gergely-ferenczy/nixie-clock/README.md

4 digit IN-8-2 Nixie clock with schematic and code implementation for a TM4C1231 microcontroller.
