gergely-ferenczy/nixie-clock/ExtendedBom.xlsx

Sheet: BOM
Qty | Value | Device | Package | Parts | Description | MANUFACTURER | PACKAGE.1 | PARAMETER | PARTNUMBER | VALUE.1 | Column1
1 | 0R05/1% | ERJ8CWFR050V | RESC3216X70N | R2 | SMD Current Sense Resistor, 0R05/1%, 1 W, 1206 [3216], Panasonic | Panasonic | 1206 | 1W | ERJ8CWFR050V | 0R05/1%
2 | 1.5M/1% | MCPWR12FTEA1504 | RESC6331X65N | R5, R6 | SMT Resistor, 1.5M, 1%, 1.5W, 2512 [6432], MULTICOMP PRO | MULTICOMP PRO | 2512 | 1.5W | MCPWR12FTEA1504 | 1.5M/1%
3 | 100k/1% | CRCW0603100KFKEA | RESC1608X50N | R1, R24, R25 | SMT Resistor, 100k/1%, 100mW, 0603, VISHAY | VISHAY | 0603 | 100mW | CRCW0603100KFKEA | 100k/1%
11 | 100n/50V | C0603C104M5RACTU | CAPC1608X80N | C1, C2, C3, C4, C5, C15, C17, C18, C20, C22, C23 | SMT Capacitor, 100n/50V, X7R, 10%, 0603, KEMET | KEMET | 0603 | X7R, 20% | C0603C104M5RACTU | 100n/50V
10 | 10k/1% | CRCW060310K0FKEA | RESC1608X50N | R3, R4, R7, R9, R14, R15, R17, R18, R22, R23 | SMT Resistor, 10k/1%, 100mW, 0603, VISHAY | VISHAY | 0603 | 100mW | CRCW060310K0FKEA | 10k/1%
4 | 10k/1% | CRCW121010K0FKEA | RESC3225X60N | R10, R11, R12, R13 | SMT Resistor, 10k/1%, 500mW, 1210, VISHAY | VISHAY | 1210 | 500mW | CRCW121010K0FKEA | 10k/1%
4 | 10n/50V | C0603C103K5RACTU | CAPC1608X80N | C19, C21, C24, C25 | SMT Capacitor, 10n/50V, X7R, 10%, 0603, KEMET | KEMET | 0603 | X7R, 10% | C0603C103K5RACTU | 10n/50V
1 | 10u/25V | C1206C106K3PACTU | CAPC3216X170N | C16 | SMT Capacitor, 10u/25V, X5R, Â±10%, 1206, KEMET | KEMET | 1206 | X5R | C1206C106K3PACTU | 10u/25V
2 | 12p/50V | C0603C120J5GACTU | CAPC1608X80N | C9, C10 | SMT Capacitor, 12p/50V, C0G/NP0, Â±5%, 0603, KEMET | KEMET | 0603 | C0G/NP0, Â±5% | C0603C120J5GACTU | 12p/50V
1 | 16 MHz | MCSJK-7U-16.00-10-10-80-B-10 | OSCCC320X250X100N | Y1 | SMT Crystal, 16 MHz, SMD, 3.2mm x 2.5mm, 10 ppm, 10 pF, 10 ppm | ABRACON | SMD-4 3.2x2.5 | Â±10ppm, 10pF | MCSJK-7U-16.00-10-10-80-B-10 | 16 MHz
2 | 1u/25V | CL10A105KA8NNNC | CAPC1608X80N | C7, C8 | SMT Capacitor, 1u/25V, X7R, 10%, 0603, SAMSUNG ELECTRO-MECHANICS | SAMSUNG ELECTRO-MECHANICS | 0603 | X7R, 10% | CL10A105KA8NNNC | 1u/25V
2 | 20p/50V | C0603C200J1GACTU | CAPC1608X80N | C11, C12 | SMT Capacitor, 20p/50V, C0G/NP0, Â±5%, 0603, KEMET | KEMET | 0603 | C0G/NP0, Â±5% | C0603C200J1GACTU | 20p/50V
1 | 2k/1% | CRCW06032K00FKEA | RESC1608X50N | R21 | SMT Resistor, 2k/1%, 100mW, 0603, VISHAY | VISHAY | 0603 | 100mW | CRCW06032K00FKEA | 2k/1%
1 | 32.768 kHz | ABS07AIG-32.768KHZ-1-T | OSCCC320X150X90N | Y2 | SMT Crystal, 32.768 kHz, SMD, 3.2mm x 1.5mm, 12.5 pF, 10 ppm | ABRACON | SMD 3.2x1.5 | Â±10 ppm, 12.5 pF | ABS07AIG-32.768KHZ-1-T | 32.768 kHz
2 | 3k3/1% | MCWR06X3301FTL | RESC1608X50N | R19, R20 | SMT Resistor, 3k3/1%, 100mW, 0603, MULTICOMP PRO | MULTICOMP PRO | 0603 | 100mW | MCWR06X3301FTL | 3k3/1%
1 | 3u3/25V | C2012X7R1E335K125 | CAPC2012X145N | C6 | SMT Capacitor, 3u3/25V, X7R, 10%, 0805, TDK | TDK | 0805 | X7R, 10% | C2012X7R1E335K125AB | 3u3/25V
1 | 470u/16V | ECA1CM471 | CAPPRD350W60D800H1150B | C13 | Electrolytic Capacitor, 470 ÂµF, 16 V, Â± 20%, Radial Leaded, Panasonic | Panasonic | Radial 8x11.5 | Alu, 20% | ECA1CM471 | 470u/16V
1 | 4u7/250V | ECA2EHG4R7 | CAPPRD350W60D800H1150B | C14 | Electrolytic Capacitor, 4.7 ÂµF, 250 V, Â± 20%, Radial Leaded, Panasonic | Panasonic | Radial 8x11.5 | Alu, 20% | ECA2EHG4R7 | 4u7/250V
1 | 501568-0607 | MOLEX_501568-0607 | MOLEX_501568-0607 | J3 | PCB Header, 1.00mm Pitch, Pico-Clasp, Single Row, Right-Angle, Surface Mount, Tin Plated, with Inner Positive Lock, 6 Circuits | MOLEX |  |  | 501568-0607 | 501568-0607
1 | 56R/1% | CRCW060356R0FKEA | RESC1608X50N | R8 | SMT Resistor, 56R/1%, 100mW, 0603, VISHAY | VISHAY | 0603 | 100mW | CRCW060333R0FKEA | 56R/1%
1 | 5k/20% | 22AR5K | 22A | R16 | Trimpot, Single Turn, Cermet, Top Adjust, 5 kohm, Surface Mount, 1 Turns | TT ELECTRONICS / BI TECHNOL | 3MM SMD |  |  | 5k/20%
1 | 91V/5% | MMSZ5270BT1G | SOD3716X135N | D1 | Zener Diode, Voltage Regulator, 91 V, 500 mW, 5 %, SOD-123, ON Semiconductor | ON Semiconductor | SOD-123 | 500mW | MMSZ5270BT1G | 91V/5%
1 | BAS321 | BAS321 | SOD2512X110N | D4 | Small Signal Diode, 250 V, 250 mA, 1.25 V, 50 ns, 9 A | NEXPERIA | SOD-323 | 250V, 250mA | BAS321/8F | BAS321
1 | BF820 | BF820 | SOT95P230X110-3N | Q8 | NPN Transistor, Bipolar (BJT), 300 V, 50 mA, 250 mW, SOT-23, NEXPERIA | NEXPERIA | SOT-23 |  | BF820
4 | CLX6E-FKC | CLX6E-FKC | CLX6E-FKC | LED1, LED2, LED3, LED4 | LED, Red, Green, Blue, SMD, Square, R 15mA, G 10mA, B 10mA, CREE | CREE | SMD 3.5x3.4x2.8 mm |  | CLX6E-FKC-CH1M1D1BB7C3D3 | CLX6E-FKC
1 | ES2G-E3/52T | ES2G-E3/52T | DIOM5436X245N | D2 | Fast / Ultrafast Diode, 400 V, 2 A, 900 mV, 35 ns, 50 A, SMB, VISHAY | VISHAY | SMB | 400V/2A | ES2G-E3/52T | ES2G-E3/52T
1 | FQD16N25CTM | FQD16N25CTM | TO230P990X240-3N | Q7 | Power MOSFET, N Channel, 250 V, 16 A, 0.22 ohm, TO-252 (DPAK), Surface Mount | ON Semiconductor | TO-252 |  | FQD16N25CTM
1 | JTAG-ARM-10PIN-PLACEHOLDER | JTAG-ARM-10PIN-PLACEHOLDER | JTAG-ARM-10PIN-PLACEHOLDER | M1 | JTAG 10-pin ARM compatible connector placeholder.
1 | MAX1771ESA+ | MAX1771ESA+ | SOIC127P600X175-8N | IC13 | DC/DC Controller, Boost (Step Up), 3 V to 16.5 V, 1 Output, 300 kHz, SOIC-8 | Maxim Integrated | SOIC-8 |  | MAX1771ESA+
1 | MCP1755T-3302E/DC | MCP1755T-3302E/DC | SOT127P700X180-6N | IC11 | Fixed LDO Voltage Regulator, 3.6V to 16V, 300mV Dropout, 3.3Vout, 300mAout, SOT-223-5, MICROCHIP | MICROCHIP | SOT-223-5 |  | MCP1755T-3302E/DC
1 | MCSDRH125B-101MHF | MCSDRH125B-101MHF | INDM120120X600N | L1 | Power Inductor (SMD), 100 ÂµH, 2.4 A, Shielded, 2.2 A, MCSDRH125B Series, 12.5mm x 12.5mm x 6mm | Multicomp PRO | Square 12.5x6 |  | MCSDRH125B-101MHF
4 | MOUNTING_HOLE_3MM | MOUNTING_HOLE_3MM | MOUNTING_HOLE_3MM | MT1, MT2, MT3, MT4
4 | NIXIE-IN-8-2 | NIXIE-IN-8-2 | NIXIE-IN-8-2 | Q1, Q2, Q3, Q4
2 | PCB Terminal | PCB_TERMINAL_PAD | PCB_TERMINAL_PAD | J1, J2 |  |  |  | 4mmx2mm |  | PCB Terminal
1 | PMEG4030ER | PMEG4010CEJ | SODFL3517X110N | D3 | Schottky Rectifier, 40 V, 3 A, 540 mV, SOD-123W, NEXPERIA | NEXPERIA | SOD-123W | 40V, 3A | PMEG4030ER,115 | PMEG4030ER
1 | S8421-45R | S8421-45R | S8421-45R | PS1 | Battery Holder (Open) Coin, 20.0mm 1 Cell SMD (SMT) Tab | Harwin |  |  | S8421-45R | S8421-45R
4 | SN74HC595DR | SN74HC595DR | SOIC127P600X175-16N | IC5, IC6, IC7, IC8 | 8-Bit Shift Register With 3-State Outputs | Texas Instruments | SOIC-16 |  | SN74HC595DR
4 | SN75468 | SN75468 | SOIC127P600X175-16N | IC1, IC2, IC3, IC4 | 100-V, 7-ch darlington array with TTL or CMOS compatibility | Texas Instruments | SOIC16 |  | SN75468D
2 | TLC5973 | TLC5973 | SOIC127P600X175-8N | IC9, IC10 | LED Driver, 3-Channel, 12-Bit, PWM Constant-Current with Single-Wire Interface, Texas Instruments | Texas Instruments | SOIC-8 |  | TLC5973 | TLC5973
1 | TM4C1231H6PMI | TM4C1231H6PMI | QFP50P1200X1200X160-64N | IC14 |  | Texas Instruments | LQFP-64 |  | TM4C1231H6PMI

Sheet: BOM (2)
Description | Partnumber | Link | QtyPerBoard | Stock | MinOrderAmount | AmountToBeOrdered | Column1
SMD Current Sense Resistor, 0R05/1%, 1 W, 1206 [3216], Panasonic | ERJ8CWFR050V | https://hu.farnell.com/panasonic/erj8cwfr050v/current-sense-res-0r05-1-1-w-1206/dp/2253991 | 1 | 0 | 10 | 10
SMT Resistor, 1.5M, 1%, 1.5W, 2512 [6432], MULTICOMP PRO | MCPWR12FTEA1504 | https://hu.farnell.com/multicomp/mcpwr12ftea1504/res-1m5-1-1-5w-2512-thick-film/dp/1887873 | 2 | 0 | 10 | 20
SMT Resistor, 100k/1%, 100mW, 0603, VISHAY | CRCW0603100KFKEA | https://hu.farnell.com/vishay/crcw0603100kfkea/res-100k-1-0-1w-0603-thick-film/dp/1469649 | 3 | 0 | 10 | 30
SMT Capacitor, 100n/50V, X7R, 10%, 0603, KEMET | C0603C104K5RACTU | https://hu.farnell.com/kemet/c0603c104k5ractu/cap-0-1-f-50v-10-x7r-0603/dp/1288255 | 11 | 0 | 10 | 110 |  | Panel count | 10
SMT Resistor, 10k/1%, 100mW, 0603, VISHAY | CRCW060310K0FKEA | https://hu.farnell.com/vishay/crcw060310k0fkea/res-10k-1-0-1w-0603-thick-film/dp/1469748 | 10 | 0 | 10 | 100
SMT Resistor, 10k/1%, 500mW, 1210, VISHAY | CRCW121010K0FKEA | https://hu.farnell.com/vishay/crcw121010k0fkeahp/res-aec-q200-10k-1-0-75w-1210/dp/3546484 | 4 | 0 | 10 | 40
SMT Capacitor, 10n/50V, X7R, 10%, 0603, KEMET | C0603C103K5RACTU | https://hu.farnell.com/kemet/c0603c103k5ractu/cap-0-01-f-50v-10-x7r-0603/dp/1414609 | 4 | 0 | 10 | 40
SMT Capacitor, 10u/25V, X5R, Â±10%, 1206, KEMET | C1206C106K3PACTU | https://hu.farnell.com/kemet/c1206c106k3pactu/cap-10-f-25v-10-x5r-1206/dp/1288206 | 1 | 0 | 5 | 10
SMT Capacitor, 12p/50V, C0G/NP0, Â±5%, 0603, KEMET | C0603C120J5GACTU | https://hu.farnell.com/kemet/c0603c120j5gactu/cap-12pf-50v-5-c0g-np0-0603/dp/1414612?st=c0603c120j5gactu | 0 | 0 | 10 | 0
SMT Crystal, 16 MHz, SMD, 3.2mm x 2.5mm, 10 ppm, 10 pF, 10 ppm | MCSJK-7U-16.00-10-10-80-B-10 | https://hu.farnell.com/multicomp/mcsjk-7u-16-00-10-10-80-b-10/crystal-16mhz-10pf-3-2mm-x-2-5mm/dp/2853934 | 0 | 0 | 5 | 0
SMT Capacitor, 1u/25V, X7R, 10%, 0603, SAMSUNG ELECTRO-MECHANICS | CL10A105KA8NNNC | https://hu.farnell.com/samsung-electro-mechanics/cl10a105ka8nnnc/cap-1uf-25v-mlcc-0603/dp/3013382 | 2 | 0 | 10 | 20
SMT Capacitor, 20p/50V, C0G/NP0, Â±5%, 0603, KEMET | C0603C200J1GACTU | https://hu.farnell.com/kemet/c0603c200j1gactu/cap-20pf-100v-5-c0g-np0-0603/dp/2821240?st=c0603c200j1gactu | 2 | 0 | 10 | 20
SMT Resistor, 2k/1%, 100mW, 0603, VISHAY | CRCW06032K00FKEA | https://hu.farnell.com/vishay/crcw06032k00fkea/res-2k-1-0-1w-0603-thick-film/dp/1469764 | 1 | 0 | 10 | 10
SMT Crystal, 32.768 kHz, SMD, 3.2mm x 1.5mm, 12.5 pF, 10 ppm | 32.768K-CFPX217 | https://www.tme.eu/hu/details/32.768k-cfpx217/smd-kvarcrezonatorok/iqd-frequency-products/lfxtal009678reel/ | 1 | 0 | 2 | 10 | x
SMT Resistor, 3k3/1%, 100mW, 0603, MULTICOMP PRO | MCWR06X3301FTL | https://hu.farnell.com/multicomp/mcwr06x3301ftl/res-3k3-1-0-1w-0603-thick-film/dp/2447359 | 2 | 0 | 10 | 20
SMT Capacitor, 3u3/25V, X7R, 10%, 0805, TDK | CGA4J1X7R1E335K125AC | https://hu.farnell.com/tdk/cga4j1x7r1e335k125ac/cap-aec-q200-3-3uf-25v-mlcc-0805/dp/3416377 | 1 | 0 | 5 | 10
Electrolytic Capacitor, 470 ÂµF, 16 V, Â± 20%, Radial Leaded, Panasonic | ECA1CM471 | https://hu.farnell.com/panasonic/eca1cm471b/cap-470-f-16v-20/dp/2805533?st=eca1cm471 | 1 | 10 | 1 | 0
Polymer Aluminium Electrolytic Capacitor, 4.7 µF, 250 V, Radial Leaded, A759 Series, 0.496 ohm | A759KS475M2EAAE496 | https://hu.farnell.com/kemet/a759ks475m2eaae496/cap-4-7-f-250v-20/dp/2614117 | 1 | 0 | 1 | 10
PCB Header, 1.00mm Pitch, Pico-Clasp, Single Row, Right-Angle, Surface Mount, Tin Plated, with Inner Positive Lock, 6 Circuits | 501568-0607 | https://hu.farnell.com/molex/501568-0607/connector-header-6pos-1row-1mm/dp/2060673 | 1 | 1 | 1 | 9
SMT Resistor, 56R/1%, 100mW, 0603, VISHAY | CRCW060356R0FKEA | https://hu.farnell.com/vishay/crcw060356r0fkea/res-56r-1-0-1w-0603-thick-film/dp/2141248 | 1 | 0 | 10 | 10
Trimpot, Single Turn, Cermet, Top Adjust, 5 kohm, Surface Mount, 1 Turns | 22AR5K | https://hu.farnell.com/tt-electronics-bi-technologies/22ar5klftr/trimmer-cermet-3mm-5k/dp/1520624?st=22ar5k | 1 | 10 | 5 | 0
Zener Diode, Voltage Regulator, 91 V, 500 mW, 5 %, SOD-123, ON Semiconductor | MMSZ5270BT1G | https://hu.farnell.com/on-semiconductor/mmsz5270bt1g/zener-diode-500mw-91v-sod-123/dp/2463595 | 1 | 3 | 5 | 10
Small Signal Diode, 250 V, 250 mA, 1.25 V, 50 ns, 9 A | BAS321/8F | https://hu.farnell.com/nexperia/bas321-8f/small-signal-diode-250v-0-25a/dp/3439589?st=bas321/8f | 1 | 10 | 5 | 0
NPN Transistor, Bipolar (BJT), 300 V, 50 mA, 250 mW, SOT-23, NEXPERIA | BF820,215 | https://hu.farnell.com/nexperia/bf820-215/transistor-npn-sot-23/dp/1081284 | 1 | 3 | 5 | 10
LED, Red, Green, Blue, SMD, Square, R 15mA, G 10mA, B 10mA, CREE | CLX6E-FKC-CH1M1D1BB7C3D3 | https://hu.farnell.com/cree/clx6e-fkc-ch1m1d1bb7c3d3/led-auto-rgb-500-950-240mcd-plcc6/dp/2839900 | 4 | 4 | 1 | 36
Fast / Ultrafast Diode, 400 V, 2 A, 900 mV, 35 ns, 50 A, SMB, VISHAY | ES2G+ | https://hu.farnell.com/multicomp/es2g/rectifier-single-2a-400v-do-214aa/dp/2674992 | 1 | 5 | 5 | 5
Power MOSFET, N Channel, 250 V, 16 A, 0.22 ohm, TO-252 (DPAK), Surface Mount | FQD16N25CTM | https://hu.farnell.com/on-semiconductor/fqd16n25ctm/mosfet-n-ch-250v-16a-to-252/dp/2101411 | 1 | 10 | 1 | 0
DC/DC Controller, Boost (Step Up), 3 V to 16.5 V, 1 Output, 300 kHz, SOIC-8 | MAX1771ESA+ | https://hu.farnell.com/maxim-integrated-products/max1771esa/controller-step-up-dc-dc-12v-1771/dp/2518766 | 1 | 2 | 1 | 8
Fixed LDO Voltage Regulator, 3.6V to 16V, 300mV Dropout, 3.3Vout, 300mAout, SOT-223-5, MICROCHIP | MCP1755T-3302E/DC | https://hu.farnell.com/microchip/mcp1755t-3302e-dc/ic-ldo-volt-reg-3-3v-0-3a-sot223/dp/2361990 | 1 | 2 | 1 | 8
Power Inductor (SMD), 100 ÂµH, 2.4 A, Shielded, 2.2 A, MCSDRH125B Series, 12.5mm x 12.5mm x 6mm | MCSDRH125B-101MHF | https://hu.farnell.com/multicomp/mcsdrh125b-101mhf/inductor-100-h-20-2pins/dp/1864459 | 1 | 5 | 5 | 5
Schottky Rectifier, 40 V, 3 A, 540 mV, SOD-123W, NEXPERIA | PMEG4030ER,115 | https://hu.farnell.com/nexperia/pmeg4030er-115/diode-schott-rect-40v-3a-sod123w/dp/1829202 | 1 | 5 | 5 | 5
Battery Holder (Open) Coin, 20.0mm 1 Cell SMD (SMT) Tab | S8421-45R | https://hu.farnell.com/harwin/s8421-45r/holder-ez-coin-cr-br2032-cells/dp/2115305 | 1 | 1 | 1 | 9
8-Bit Shift Register With 3-State Outputs | SN74HC595DR | https://hu.farnell.com/texas-instruments/sn74hc595dr/ic-8bit-sipo-shift-register-soic/dp/3006739 | 4 | 0 | 5 | 40
100-V, 7-ch darlington array with TTL or CMOS compatibility | SN75468D | https://hu.farnell.com/texas-instruments/sn75468d/transistor-array-75468-soic16/dp/3009691 | 4 | 0 | 1 | 40
LED Driver, 3-Channel, 12-Bit, PWM Constant-Current with Single-Wire Interface, Texas Instruments | TLC5973 | https://hu.farnell.com/texas-instruments/tlc5973d/led-driver-linear-3mhz-soic-8/dp/3006041 | 2 | 2 | 1 | 18
 | TM4C1231H6PMI | https://hu.farnell.com/texas-instruments/tm4c1231h6pmi/mcu-32bit-cortex-m4f-80mhz-lqfp/dp/3123140 | 1 | 0 | 1 | 10
Phototransistor, 570 nm, 150 °, 2 Pins, Radial Leaded | SFH 3310 | https://hu.farnell.com/osram-opto-semiconductors/sfh-3310/photo-trans-npn-570nm-radial-leaded/dp/2981743 | 1 | 5 | 5 | 5
Contact, Pico-Clasp 501334 Series, Socket, Crimp, 28 AWG, Tin Plated Contacts | 501334-0100 | https://hu.farnell.com/molex/501334-0100/contact-socket-28awg-crimp/dp/1836000 | 6 | 50 | 10 | 10
Connector Housing, Pico-Clasp 501330, Receptacle, 6 Ways, 1 mm, 501334, 501193 Crimp Terminals | 501330-0600 | https://hu.farnell.com/molex/501330-0600/connector-rcpt-6pos-1row-1mm/dp/1835964 | 1 | 1 | 1 | 9
Rotary Encoder, Mechanical, Incremental, 24 PPR, 24 Detents, Vertical, With Momentary Push Switch | PEC11R-4215F-S0024 | https://hu.farnell.com/bourns/pec11r-4215f-s0024/incremental-encoder-2ch-24pulse/dp/2474844 | 1 | 0 | 1 | 10 | x
Socket; DC supply; male; 5.5/2.1mm; with on/off switch; soldering | NEB/J 21 C | https://www.tme.eu/en/details/neb_j21c/dc-power-connectors/lumberg/neb-j-21-c/ | 1 | 5 | 1 | 5 | x
IC & Component Socket, 20 Contacts, SIP Socket, 2.54 mm, D01 Series, Beryllium Copper | D01-9972042 | https://hu.farnell.com/harwin/d01-9972042/socket-sil-20way/dp/1023034 | 44 | 200 | 20 | 240
AC/DC Power Supply, ITE, 1 Output, 12 W, 9 V, 1.28 A | VEL12US090-EU-JA | https://hu.farnell.com/xp-power/vel12us090-eu-ja/adaptor-ac-dc-9v-1-28a/dp/2524419 | 1 | 0 | 1 | 10
