gergely-ferenczy/nixie-clock/Stand-NT-IN-8-2 v1.stl

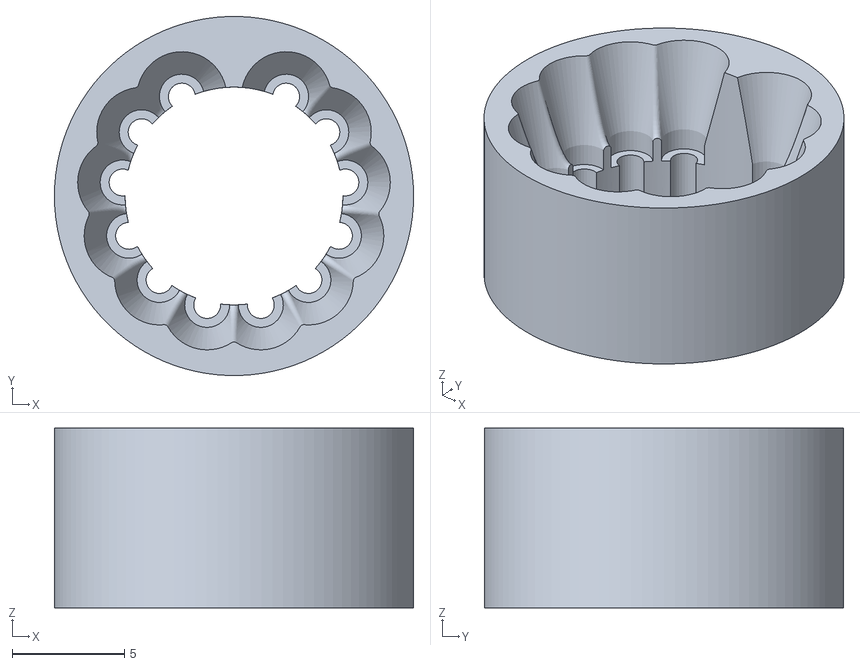
[picture p1: CAD file, 2021-07-18]
Stand-NT-IN-8-2 v1.stl
16.0 x 16.0 x 8.00
