gergely-ferenczy/nixie-clock/NixieClock.dxf

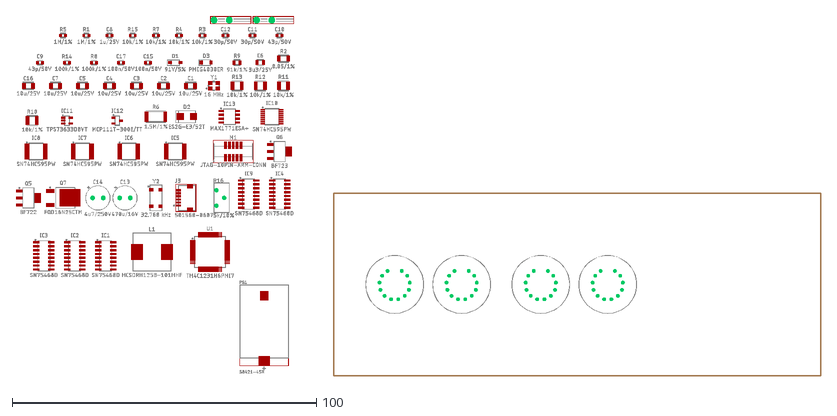
[picture p2: CAD file, 2020-12-04]
NixieClock.dxf
264.3 x 118.1
