gergely-ferenczy/nixie-clock/NixieClock.brd

## EAGLE design NixieClock.brd (2024-01-02)

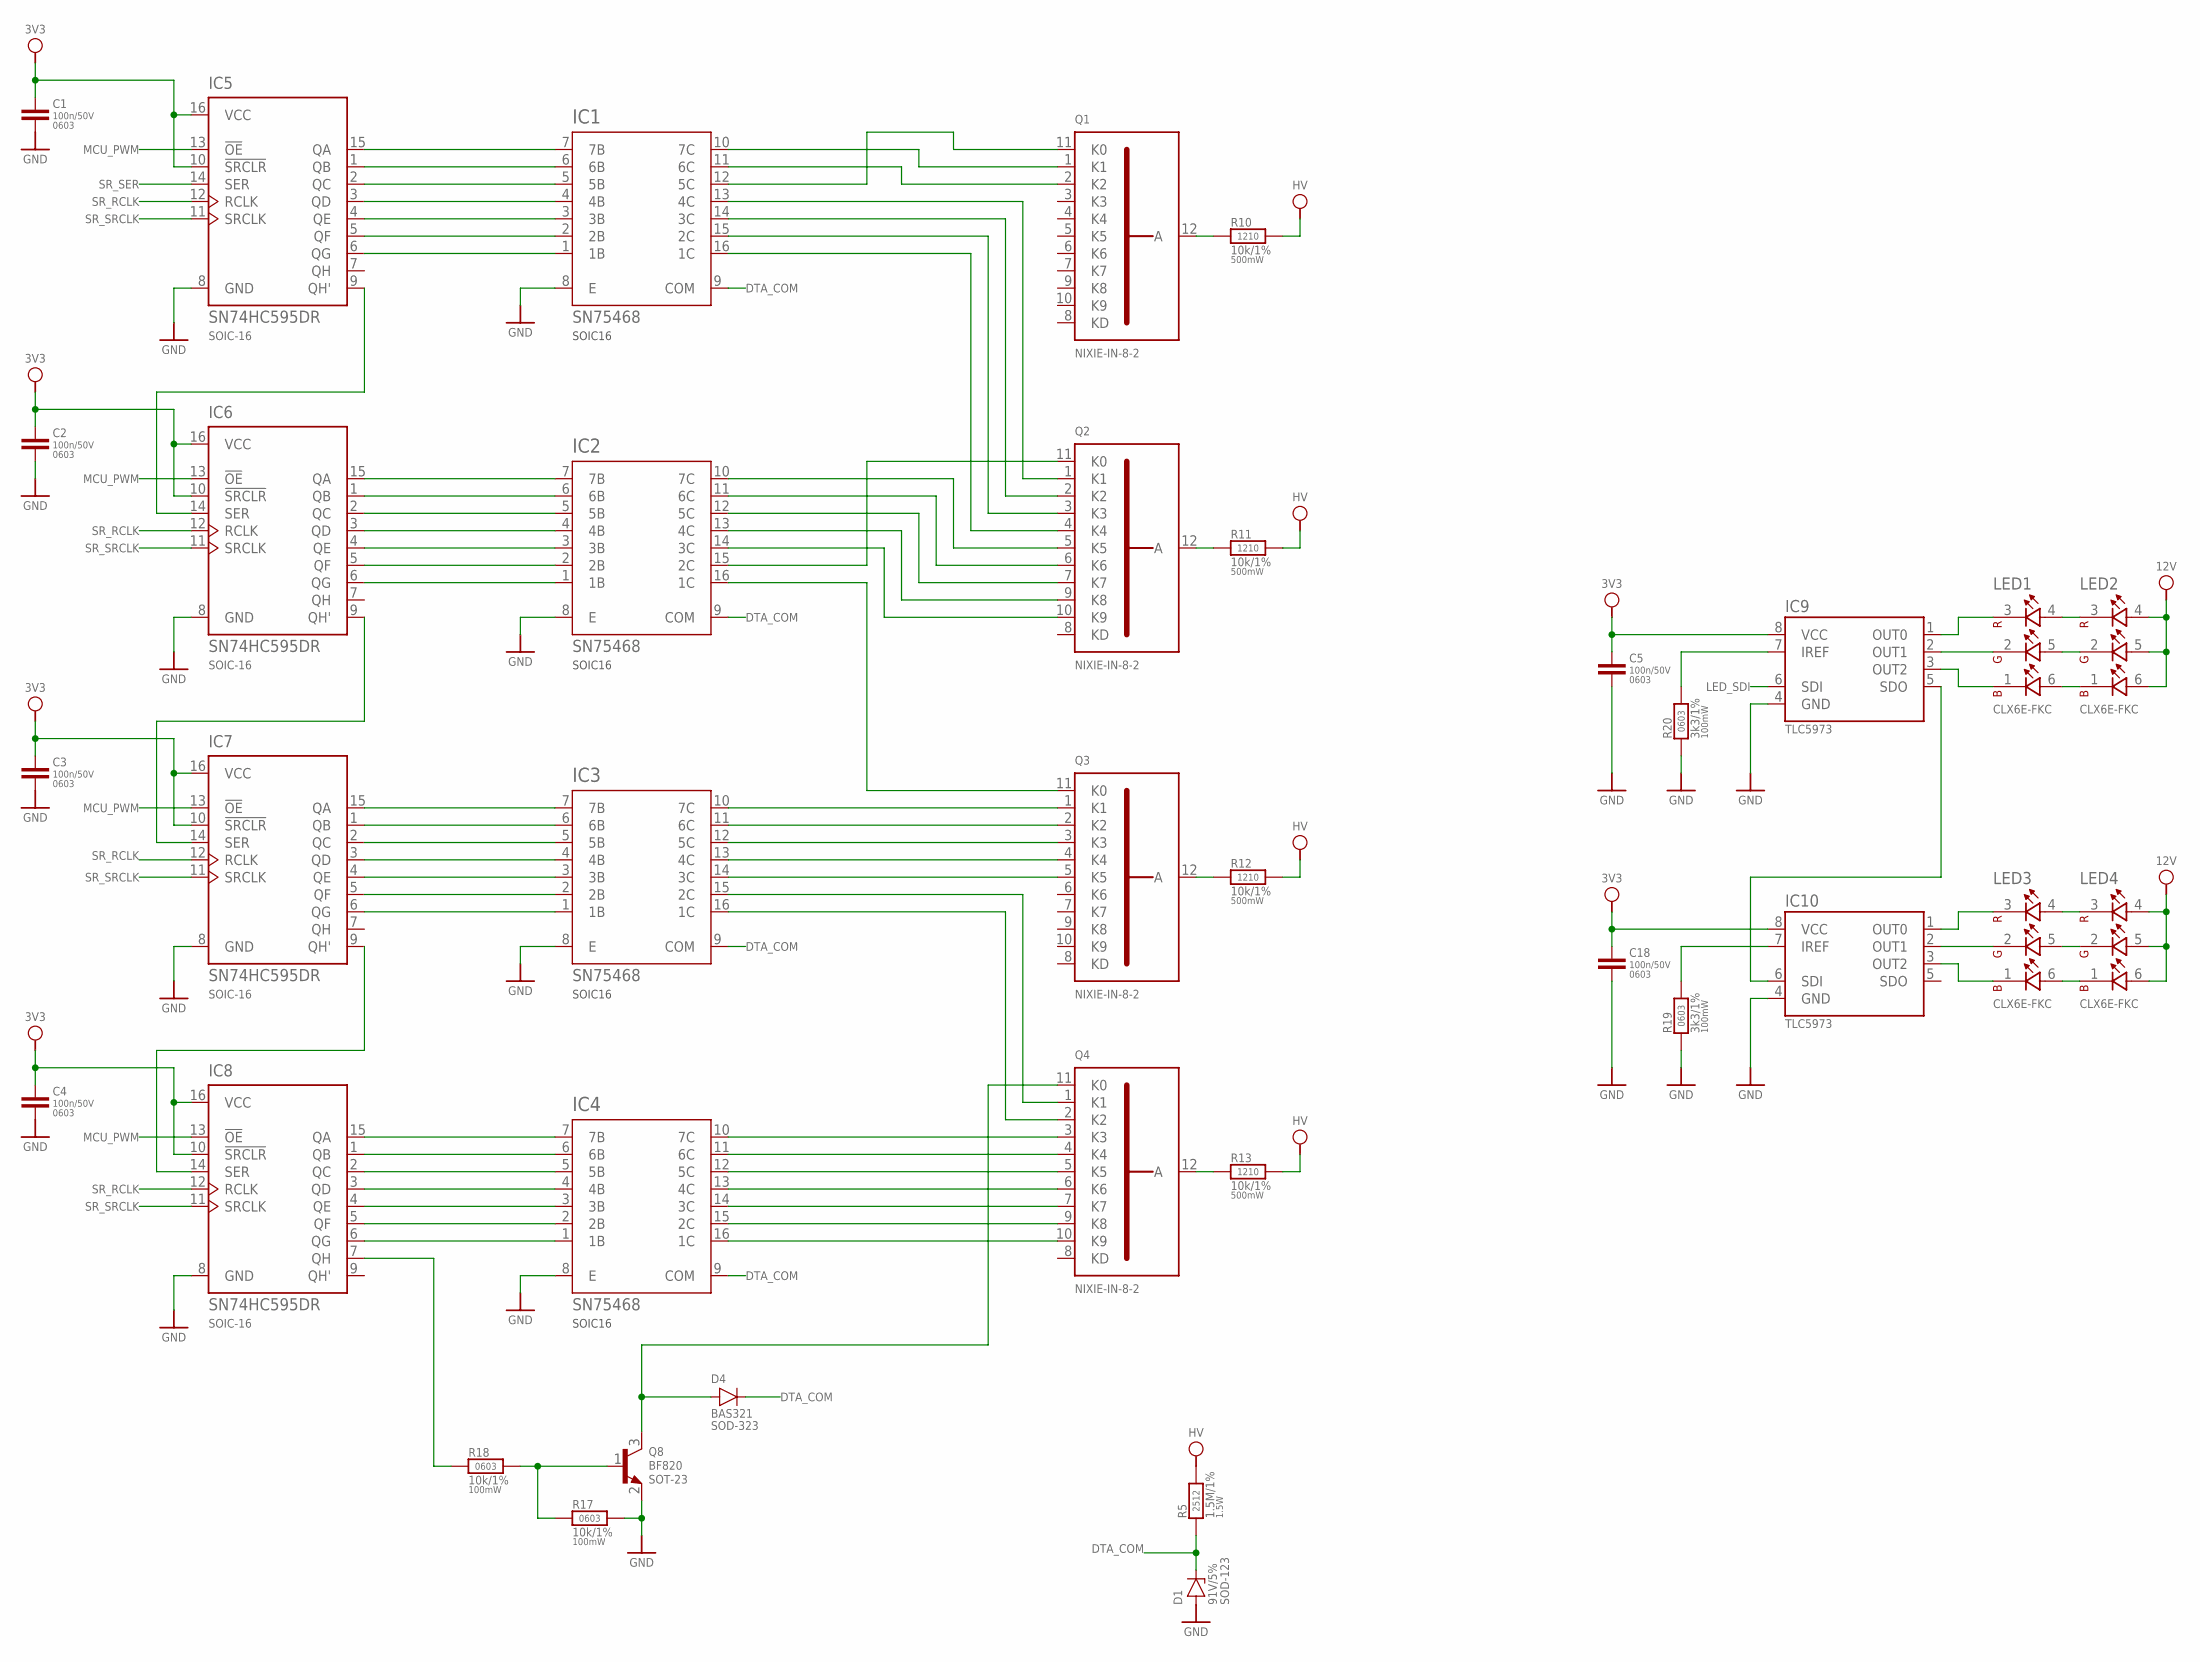
[picture p9: schematic NixieClock.sch, sheet 1, Nixie Control And Driver]

Parts:
C1, C2, C3, C4, C5, C18: 100n/50V; CAPC1608X80N
D1: 91V/5%; SOD3716X135N
D4: BAS321; SOD2512X110N
IC1, IC2, IC3, IC4: SN75468; SOIC127P600X175-16N
IC5, IC6, IC7, IC8: SN74HC595DR; SOIC127P600X175-16N
IC9, IC10: TLC5973; SOIC127P600X175-8N
LED1, LED2, LED3, LED4: CLX6E-FKC
Q1, Q2, Q3, Q4: NIXIE-IN-8-2
Q8: BF820; SOT95P230X110-3N
R5: 1.5M/1%; RESC6331X65N
R10, R11, R12, R13: 10k/1%; RESC3225X60N
R17, R18: 10k/1%; RESC1608X50N
R19, R20: 3k3/1%; RESC1608X50N

Connections:
3V3: C1.1, C2.1, C3.1, C4.1, C5.1, C18.1, IC5.10 (!SRCLR), IC5.16 (VCC), IC6.10 (!SRCLR), IC6.16 (VCC), IC7.10 (!SRCLR), IC7.16 (VCC), IC8.10 (!SRCLR), IC8.16 (VCC), IC9.8 (VCC), IC10.8 (VCC); also elsewhere on the board
12V: LED2.4 (ARED), LED2.5 (AGREEN), LED2.6 (ABLUE), LED4.4 (ARED), LED4.5 (AGREEN), LED4.6 (ABLUE); also elsewhere on the board
DTA_COM: D1.1, D4.1, IC1.9 (COM), IC2.9 (COM), IC3.9 (COM), IC4.9 (COM), R5.1
GND: C1.2, C2.2, C3.2, C4.2, C5.2, C18.2, D1.2, IC1.8 (E), IC2.8 (E), IC3.8 (E), IC4.8 (E), IC5.8 (GND), IC6.8 (GND), IC7.8 (GND), IC8.8 (GND), IC9.4 (GND), IC10.4 (GND), Q8.2 (E), R17.2, R19.1, R20.1; also elsewhere on the board
HV: R5.2, R10.2, R11.2, R12.2, R13.2; also elsewhere on the board
LED_SDI: IC9.6 (SDI); also elsewhere on the board
MCU_PWM: IC5.13 (!OE), IC6.13 (!OE), IC7.13 (!OE), IC8.13 (!OE); also elsewhere on the board
unnamed: IC1.7 (7B), IC5.15 (QA)
unnamed: IC1.6 (6B), IC5.1 (QB)
unnamed: IC1.5 (5B), IC5.2 (QC)
unnamed: IC1.4 (4B), IC5.3 (QD)
unnamed: IC1.3 (3B), IC5.4 (QE)
unnamed: IC1.2 (2B), IC5.5 (QF)
unnamed: IC1.1 (1B), IC5.6 (QG)
unnamed: IC5.9 (QH'), IC6.14 (SER)
unnamed: IC1.10 (7C), Q1.1 (K1)
unnamed: IC1.11 (6C), Q1.2 (K2)
unnamed: IC1.12 (5C), Q1.11 (K0)
unnamed: IC1.13 (4C), Q2.1 (K1)
unnamed: IC1.14 (3C), Q2.2 (K2)
unnamed: IC1.15 (2C), Q2.3 (K3)
unnamed: IC1.16 (1C), Q2.4 (K4)
unnamed: IC6.9 (QH'), IC7.14 (SER)
unnamed: IC2.10 (7C), Q2.5 (K5)
unnamed: IC2.11 (6C), Q2.6 (K6)
unnamed: IC2.12 (5C), Q2.7 (K7)
unnamed: IC2.13 (4C), Q2.9 (K8)
unnamed: IC2.14 (3C), Q2.10 (K9)
unnamed: IC2.15 (2C), Q2.11 (K0)
unnamed: IC2.7 (7B), IC6.15 (QA)
unnamed: IC7.9 (QH'), IC8.14 (SER)
unnamed: IC2.6 (6B), IC6.1 (QB)
unnamed: IC2.5 (5B), IC6.2 (QC)
unnamed: IC2.4 (4B), IC6.3 (QD)
unnamed: IC2.3 (3B), IC6.4 (QE)
unnamed: IC2.2 (2B), IC6.5 (QF)
unnamed: IC2.1 (1B), IC6.6 (QG)
unnamed: IC3.7 (7B), IC7.15 (QA)
unnamed: IC3.6 (6B), IC7.1 (QB)
unnamed: IC3.5 (5B), IC7.2 (QC)
unnamed: IC3.4 (4B), IC7.3 (QD)
unnamed: IC3.3 (3B), IC7.4 (QE)
unnamed: IC3.2 (2B), IC7.5 (QF)
unnamed: IC3.1 (1B), IC7.6 (QG)
unnamed: IC8.7 (QH), R18.1
unnamed: IC9.1 (OUT0), LED1.3 (CRED)
unnamed: IC9.3 (OUT2), LED1.1 (CBLUE)
unnamed: IC9.2 (OUT1), LED1.2 (CGREEN)
unnamed: IC4.11 (6C), Q4.4 (K4)
unnamed: IC10.1 (OUT0), LED3.3 (CRED)
unnamed: IC4.7 (7B), IC8.15 (QA)
unnamed: IC4.6 (6B), IC8.1 (QB)
unnamed: IC4.5 (5B), IC8.2 (QC)
unnamed: IC4.4 (4B), IC8.3 (QD)
unnamed: IC4.3 (3B), IC8.4 (QE)
unnamed: IC4.2 (2B), IC8.5 (QF)
unnamed: IC4.1 (1B), IC8.6 (QG)
unnamed: IC2.16 (1C), Q3.11 (K0)
unnamed: IC3.14 (3C), Q3.5 (K5)
unnamed: IC3.13 (4C), Q3.4 (K4)
unnamed: IC3.12 (5C), Q3.3 (K3)
unnamed: Q1.12 (A), R10.1
unnamed: IC3.11 (6C), Q3.2 (K2)
unnamed: IC3.10 (7C), Q3.1 (K1)
unnamed: IC3.15 (2C), Q4.1 (K1)
unnamed: IC3.16 (1C), Q4.2 (K2)
unnamed: IC4.10 (7C), Q4.3 (K3)
unnamed: IC4.12 (5C), Q4.5 (K5)
unnamed: IC4.13 (4C), Q4.6 (K6)
unnamed: IC4.14 (3C), Q4.7 (K7)
unnamed: Q8.1 (B), R17.1, R18.2
unnamed: IC4.15 (2C), Q4.9 (K8)
unnamed: IC4.16 (1C), Q4.10 (K9)
unnamed: D4.2, Q4.11 (K0), Q8.3 (C)
unnamed: IC10.2 (OUT1), LED3.2 (CGREEN)
unnamed: IC10.3 (OUT2), LED3.1 (CBLUE)
unnamed: Q2.12 (A), R11.1
unnamed: Q3.12 (A), R12.1
unnamed: Q4.12 (A), R13.1
unnamed: LED3.4 (ARED), LED4.3 (CRED)
unnamed: LED3.5 (AGREEN), LED4.2 (CGREEN)
unnamed: LED3.6 (ABLUE), LED4.1 (CBLUE)
unnamed: LED1.4 (ARED), LED2.3 (CRED)
unnamed: LED1.5 (AGREEN), LED2.2 (CGREEN)
unnamed: LED1.6 (ABLUE), LED2.1 (CBLUE)
unnamed: IC9.7 (IREF), R20.2
unnamed: IC10.7 (IREF), R19.2
unnamed: IC9.5 (SDO), IC10.6 (SDI)
SR_RCLK: IC5.12 (RCLK), IC6.12 (RCLK), IC7.12 (RCLK), IC8.12 (RCLK); also elsewhere on the board
SR_SER: IC5.14 (SER); also elsewhere on the board
SR_SRCLK: IC5.11 (SRCLK), IC6.11 (SRCLK), IC7.11 (SRCLK), IC8.11 (SRCLK); also elsewhere on the board

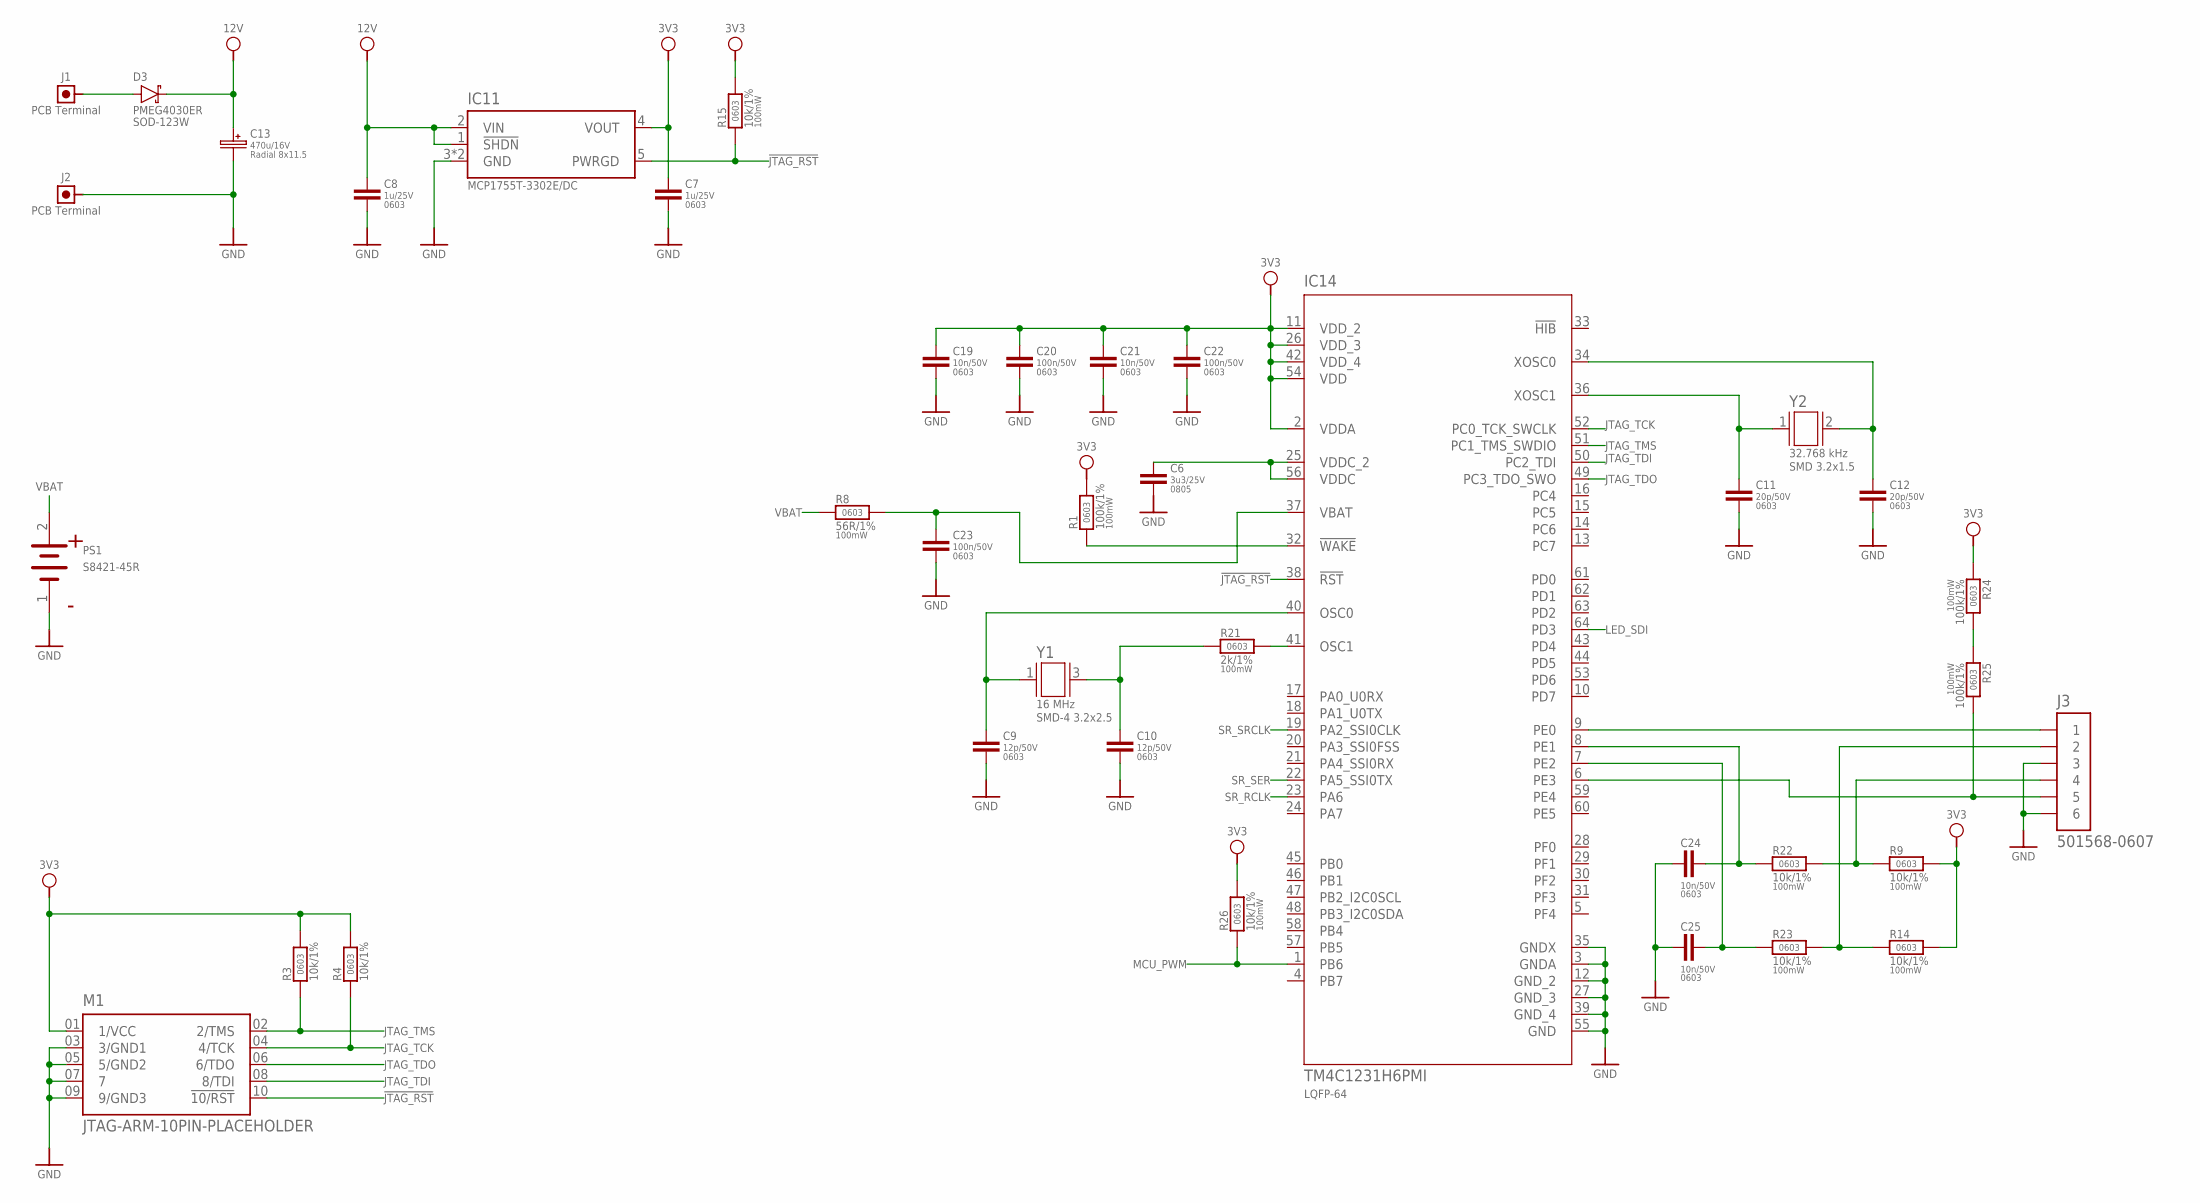
[picture p10: schematic NixieClock.sch, sheet 2, MCU And Connectors]

Parts:
C6: 3u3/25V; CAPC2012X145N
C7, C8: 1u/25V; CAPC1608X80N
C9, C10: 12p/50V; CAPC1608X80N
C11, C12: 20p/50V; CAPC1608X80N
C13: 470u/16V; CAPPRD350W60D800H1150B
C19, C21, C24, C25: 10n/50V; CAPC1608X80N
C20, C22, C23: 100n/50V; CAPC1608X80N
D3: PMEG4030ER; SODFL3517X110N
IC11: MCP1755T-3302E/DC; SOT127P700X180-6N
IC14: TM4C1231H6PMI; QFP50P1200X1200X160-64N
J1, J2: PCB Terminal; PCB_TERMINAL_PAD
J3: 501568-0607; MOLEX_501568-0607
M1: JTAG-ARM-10PIN-PLACEHOLDER
PS1: S8421-45R
R1, R24, R25: 100k/1%; RESC1608X50N
R3, R4, R9, R14, R15, R22, R23, R26: 10k/1%; RESC1608X50N
R8: 56R/1%; RESC1608X50N
R21: 2k/1%; RESC1608X50N
Y1: 16 MHz; OSCCC320X250X100N
Y2: 32.768 kHz; OSCCC320X150X90N

Connections:
3V3: C7.1, C19.1, C20.1, C21.1, C22.1, IC11.4 (VOUT), IC14.2 (VDDA), IC14.11 (VDD_2), IC14.26 (VDD_3), IC14.42 (VDD_4), IC14.54 (VDD), M1.01 (1/VCC), R1.2, R3.2, R4.2, R9.2, R14.2, R15.2, R24.1, R26.2; also elsewhere on the board
12V: C8.1, C13.1, D3.1, IC11.1 (!SHDN), IC11.2 (VIN); also elsewhere on the board
!JTAG_RST: IC11.5 (PWRGD), IC14.38 (!RST), M1.10 (!10/RST), R15.1
!WAKE: IC14.32 (!WAKE), R1.1
GND: C6.2, C7.2, C8.2, C9.2, C10.2, C11.2, C12.2, C13.2, C19.2, C20.2, C21.2, C22.2, C23.2, C24.1, C25.1, IC11.3 (GND), IC11.6 (GND), IC14.3 (GNDA), IC14.12 (GND_2), IC14.27 (GND_3), IC14.35 (GNDX), IC14.39 (GND_4), IC14.55 (GND), J2.1, J3.3, J3.6, M1.03 (3/GND1), M1.05 (5/GND2), M1.07 (7), M1.09 (9/GND3), PS1.1 (CATHODE); also elsewhere on the board
JTAG_TCK: IC14.52 (PC0_TCK_SWCLK), M1.04 (4/TCK), R4.1
JTAG_TDI: IC14.50 (PC2_TDI), M1.08 (8/TDI)
JTAG_TDO: IC14.49 (PC3_TDO_SWO), M1.06 (6/TDO)
JTAG_TMS: IC14.51 (PC1_TMS_SWDIO), M1.02 (2/TMS), R3.1
LED_SDI: IC14.64 (PD3); also elsewhere on the board
MCU_LS: IC14.6 (PE3), J3.5, R25.2
MCU_PWM: IC14.1 (PB6), R26.1; also elsewhere on the board
MCU_QEA: C24.2, IC14.8 (PE1), R22.1
MCU_QEB: C25.2, IC14.7 (PE2), R23.1
MCU_SW: IC14.9 (PE0), J3.1
MCU_VBAT: C23.1, IC14.37 (VBAT), R8.2
MCU_VDDC: C6.1, IC14.25 (VDDC_2), IC14.56 (VDDC)
unnamed: R24.2, R25.1
unnamed: IC14.41 (OSC1), R21.2
OSC0: C9.1, IC14.40 (OSC0), Y1.1
OSC1: C10.1, R21.1, Y1.3 (2)
QEA_RAW: J3.4, R9.1, R22.2
QEB_RAW: J3.2, R14.1, R23.2
SR_RCLK: IC14.23 (PA6); also elsewhere on the board
SR_SER: IC14.22 (PA5_SSI0TX); also elsewhere on the board
SR_SRCLK: IC14.19 (PA2_SSI0CLK); also elsewhere on the board
VBAT: PS1.2 (ANODE), R8.1
VSUPP: D3.2, J1.1
XOSC0: C12.1, IC14.34 (XOSC0), Y2.2
XOSC1: C11.1, IC14.36 (XOSC1), Y2.1

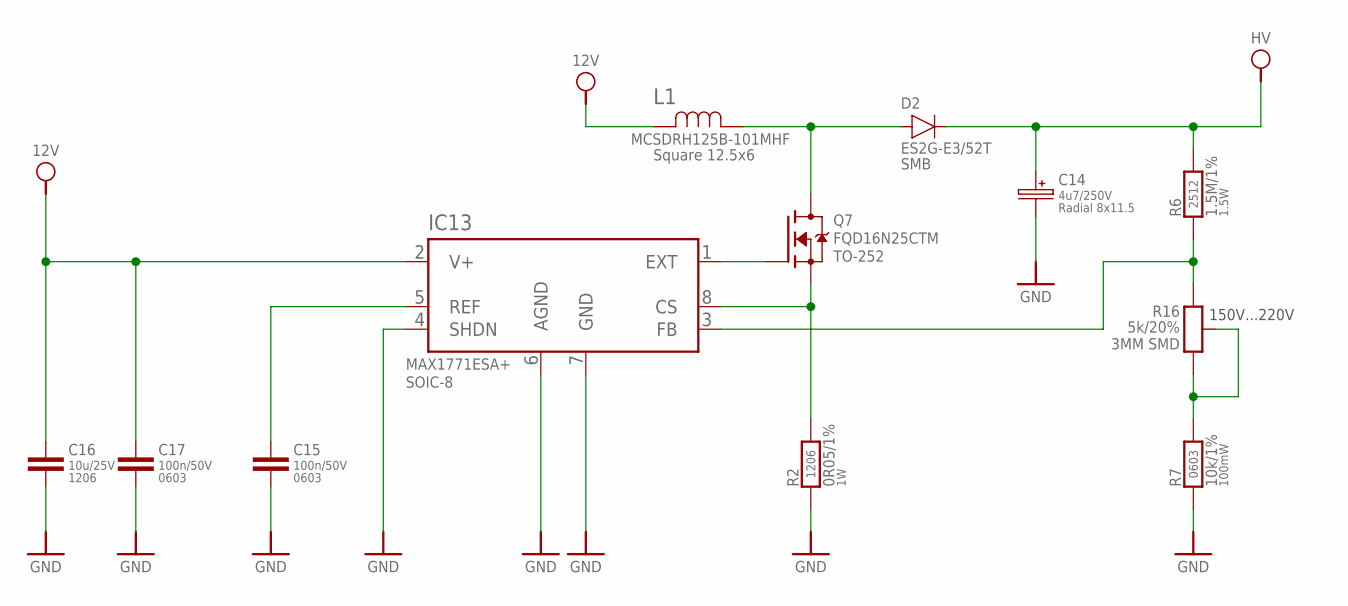
[picture p11: schematic NixieClock.sch, sheet 3, High Voltage Supply]

Parts:
C14: 4u7/250V; CAPPRD350W60D800H1150B
C15, C17: 100n/50V; CAPC1608X80N
C16: 10u/25V; CAPC3216X170N
D2: ES2G-E3/52T; DIOM5436X245N
IC13: MAX1771ESA+; SOIC127P600X175-8N
L1: MCSDRH125B-101MHF; INDM120120X600N
Q7: FQD16N25CTM; TO230P990X240-3N
R2: 0R05/1%; RESC3216X70N
R6: 1.5M/1%; RESC6331X65N
R7: 10k/1%; RESC1608X50N
R16: 5k/20%; 22A

Connections:
12V: C16.1, C17.1, IC13.2 (V+), L1.1; also elsewhere on the board
CS: IC13.8 (CS), Q7.3 (S), R2.2
FB: IC13.3 (FB), R6.1, R16.P$1 (1)
GND: C14.2, C15.2, C16.2, C17.2, IC13.4 (SHDN), IC13.6 (AGND), IC13.7 (GND), R2.1, R7.1; also elsewhere on the board
HV: C14.1, D2.1, R6.2; also elsewhere on the board
unnamed: IC13.1 (EXT), Q7.1 (G)
unnamed: R7.2, R16.P$2 (2), R16.P$3 (3)
REF: C15.1, IC13.5 (REF)
SW: D2.2, L1.2, Q7.4 (D)

Notes on the sheet:
150V...220V

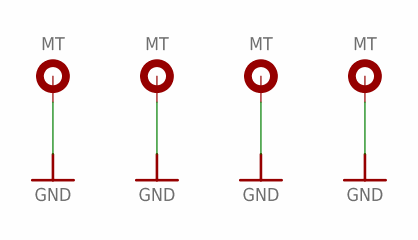
[picture p12: schematic NixieClock.sch, sheet 4, Miscellaneous]

Parts:
MT1, MT2, MT3, MT4: MOUNTING_HOLE_3MM

Connections:
GND: MT1.0, MT1.1, MT1.2, MT1.3, MT1.4, MT1.5, MT1.6, MT1.7, MT1.8, MT2.0, MT2.1, MT2.2, MT2.3, MT2.4, MT2.5, MT2.6, MT2.7, MT2.8, MT3.0, MT3.1, MT3.2, MT3.3, MT3.4, MT3.5, MT3.6, MT3.7, MT3.8, MT4.0, MT4.1, MT4.2, MT4.3, MT4.4, MT4.5, MT4.6, MT4.7, MT4.8; also elsewhere on the board

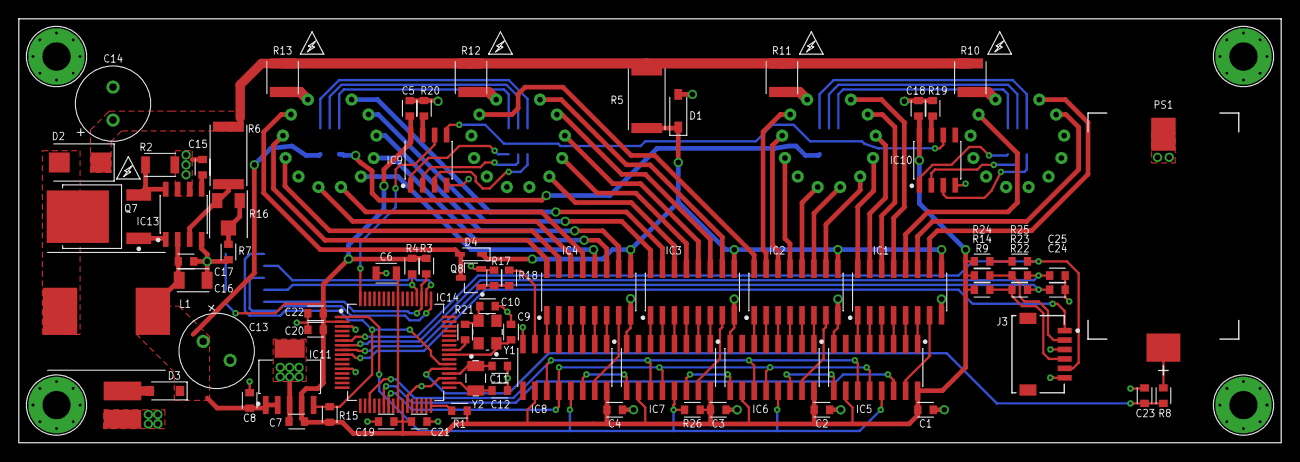
[picture p13: board NixieClock.brd from above]

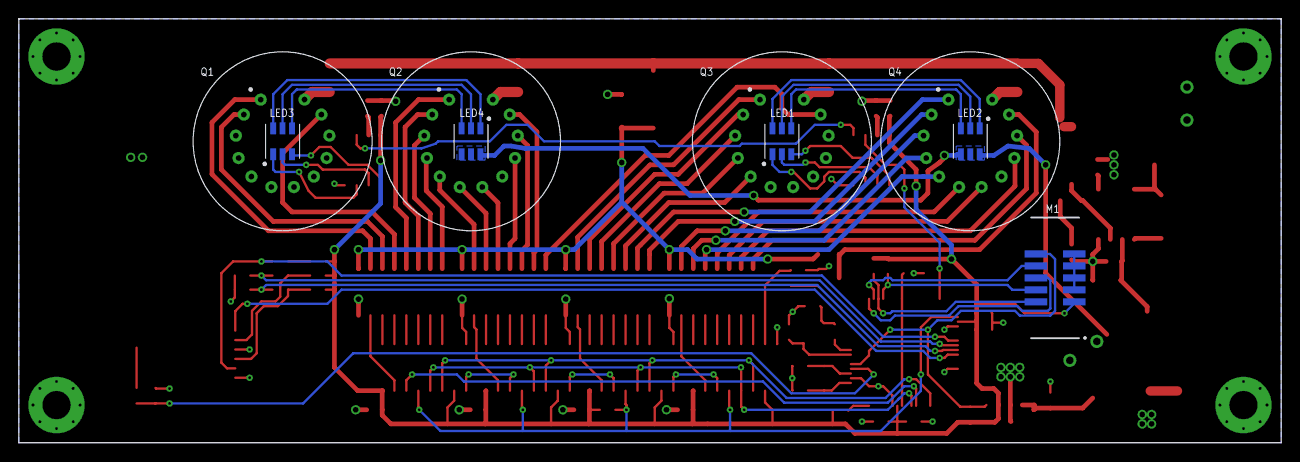
[picture p14: board NixieClock.brd from below]

Board: 2 copper layers, 134.0 x 45.0 mm, 90 parts (9 on the bottom side), 119 nets.
